MOONx02/wearable-mic-array/esp32s3/docs/flow_captions.png

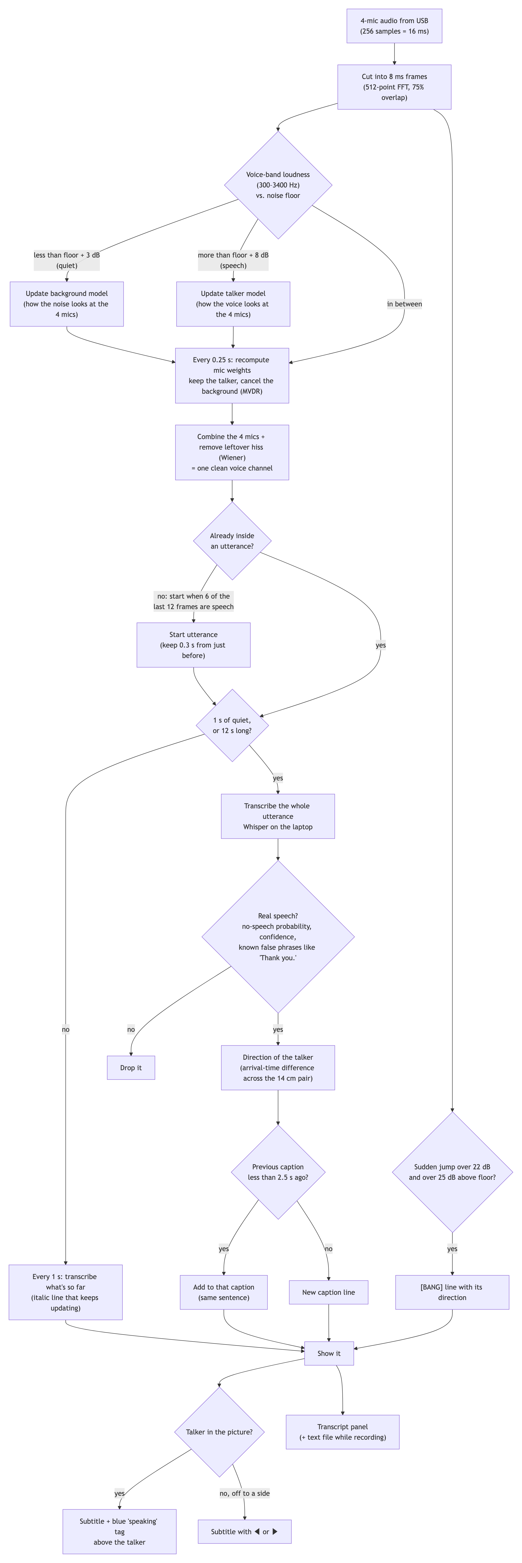
esp32s3/docs/flow_captions.png
