MOONx02/wearable-mic-array/esp32s3/docs/flow_firmware.png

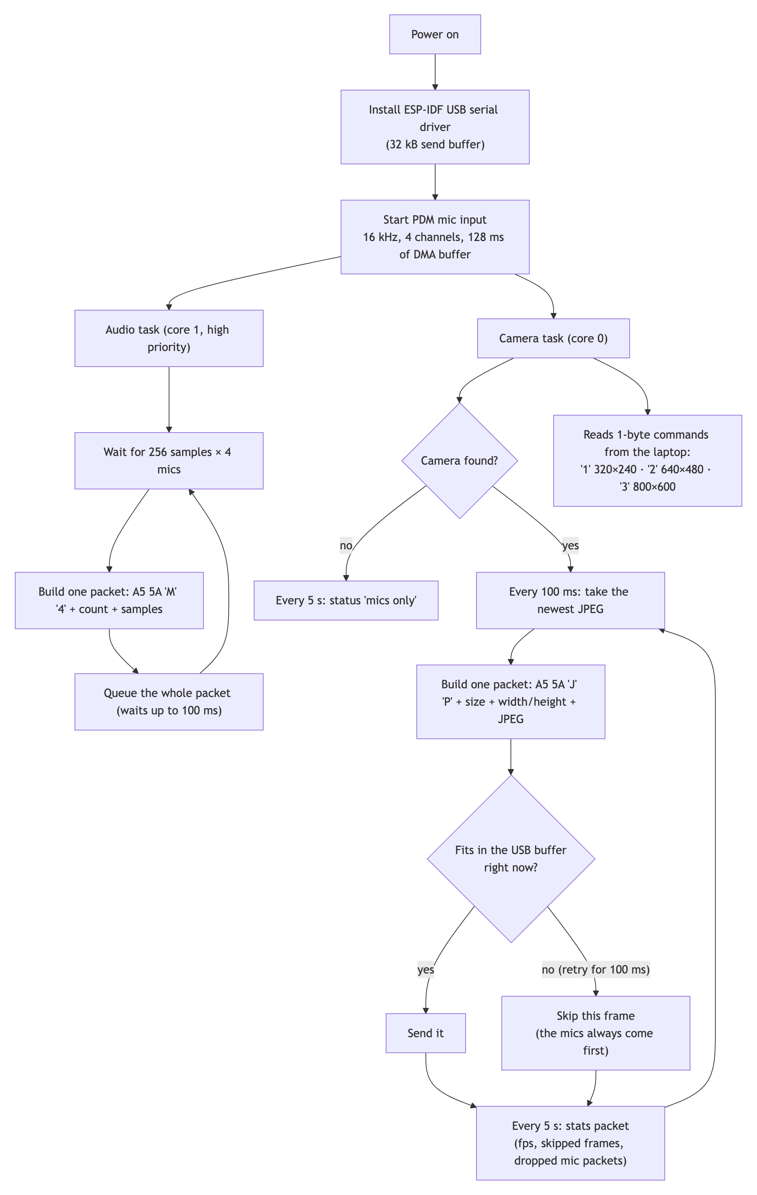
esp32s3/docs/flow_firmware.png
