MOONx02/wearable-mic-array/esp32s3/docs/flow_system.png

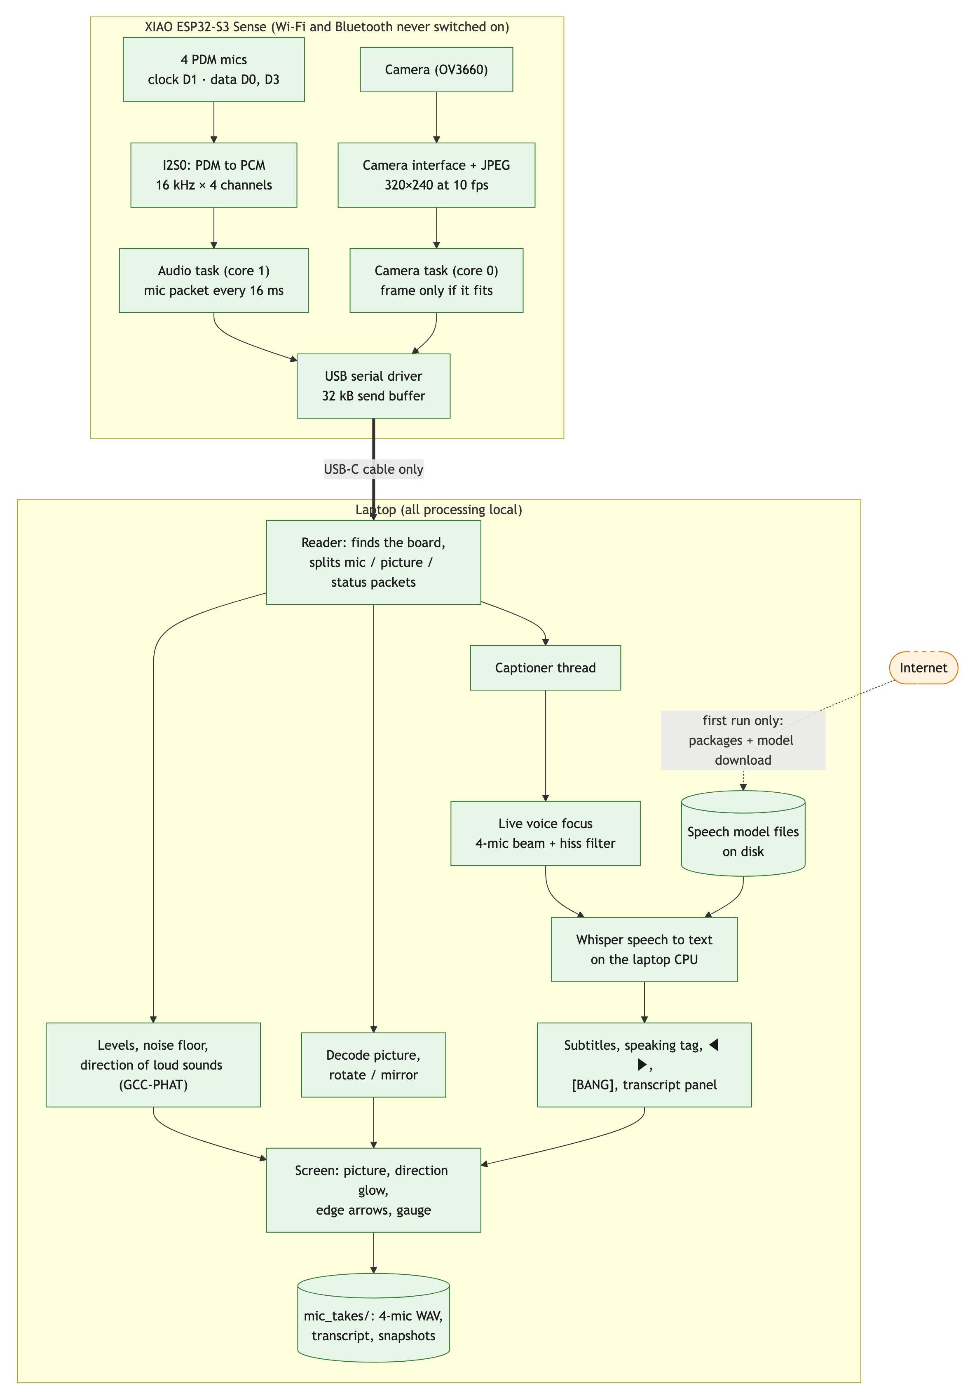
esp32s3/docs/flow_system.png
