MOONx02/wearable-mic-array/esp32s3/docs/readme_flow_locate_overlay.png

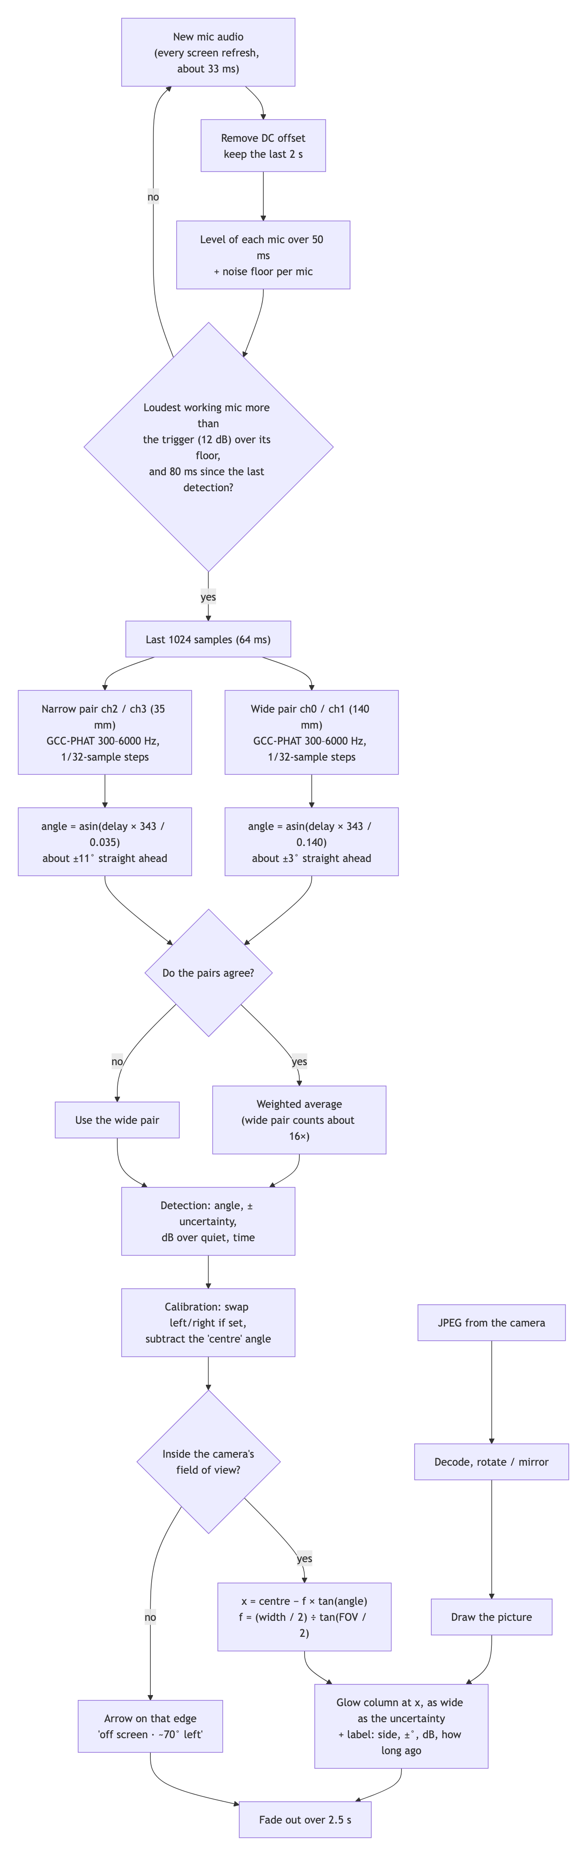
esp32s3/docs/readme_flow_locate_overlay.png
