MOONx02/wearable-mic-array/esp32s3/docs/readme_flow_overview.png

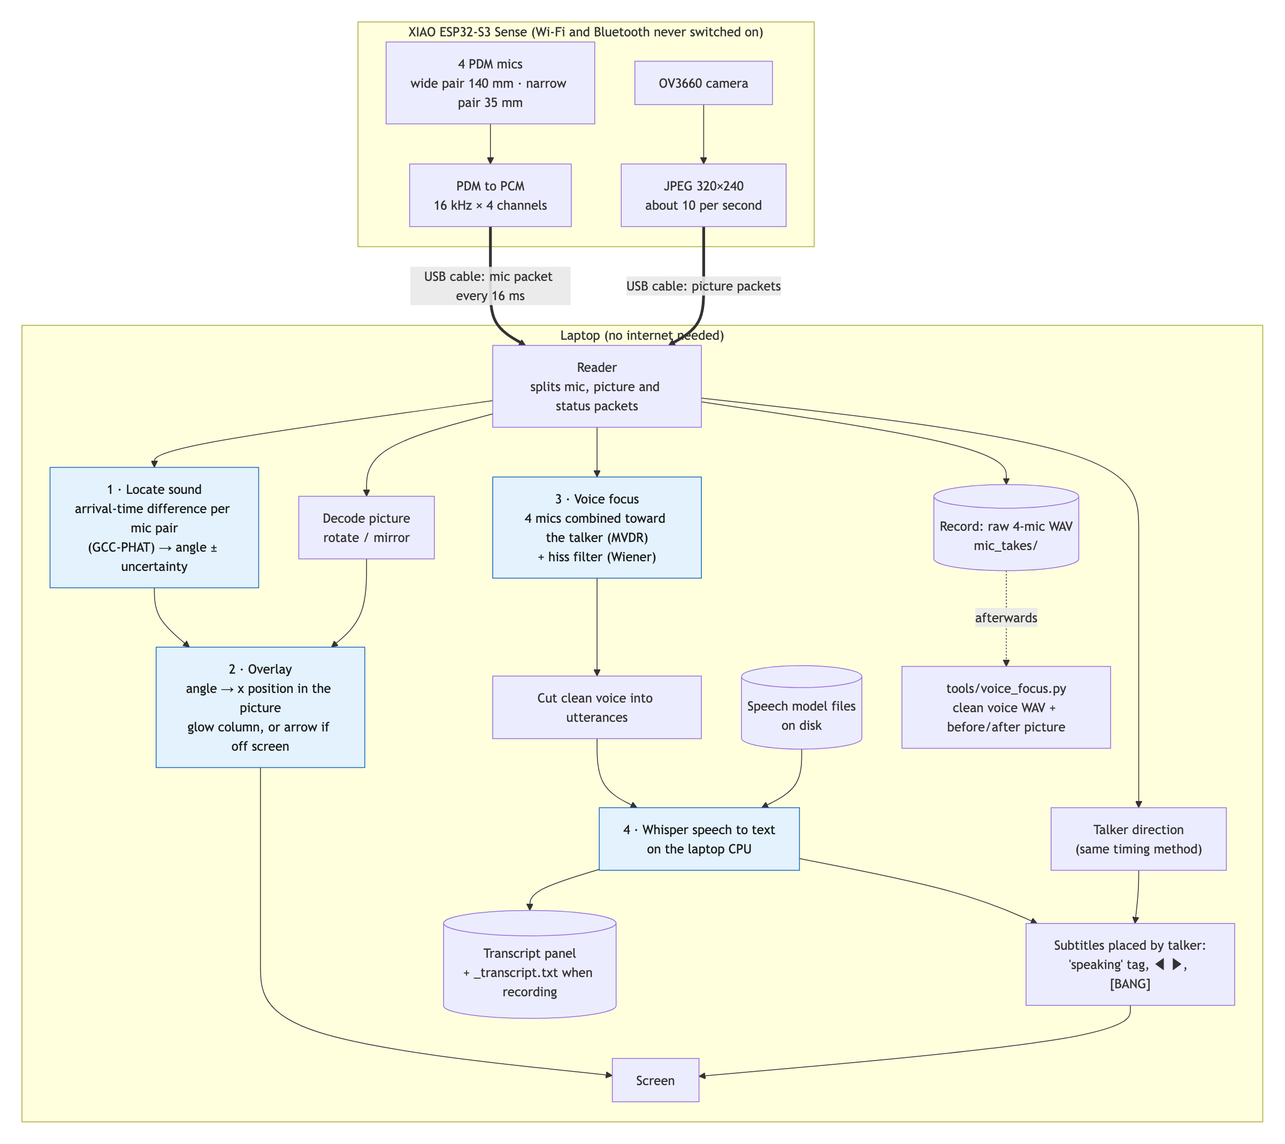
esp32s3/docs/readme_flow_overview.png
