MOONx02/wearable-mic-array/hud/out/hud_auto_t09.0.png

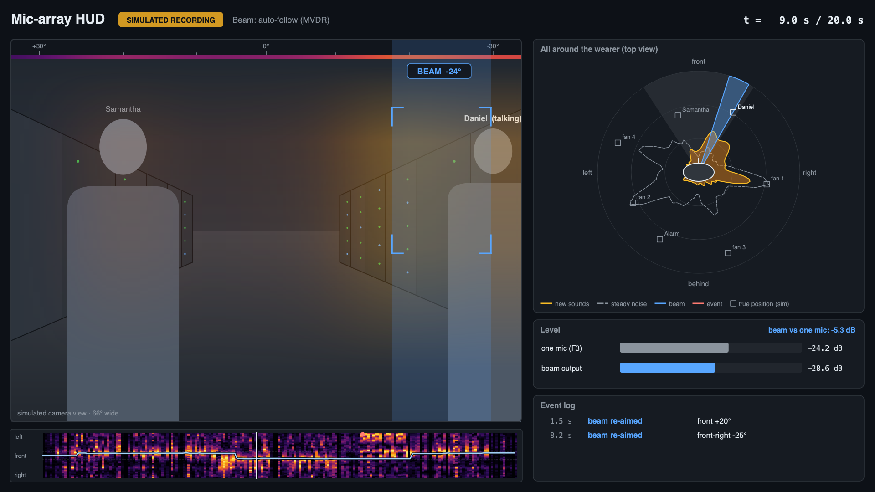
hud/out/hud_auto_t09.0.png
