MOONx02/wearable-mic-array/esp32s3/two_mic_bench_wiring.png

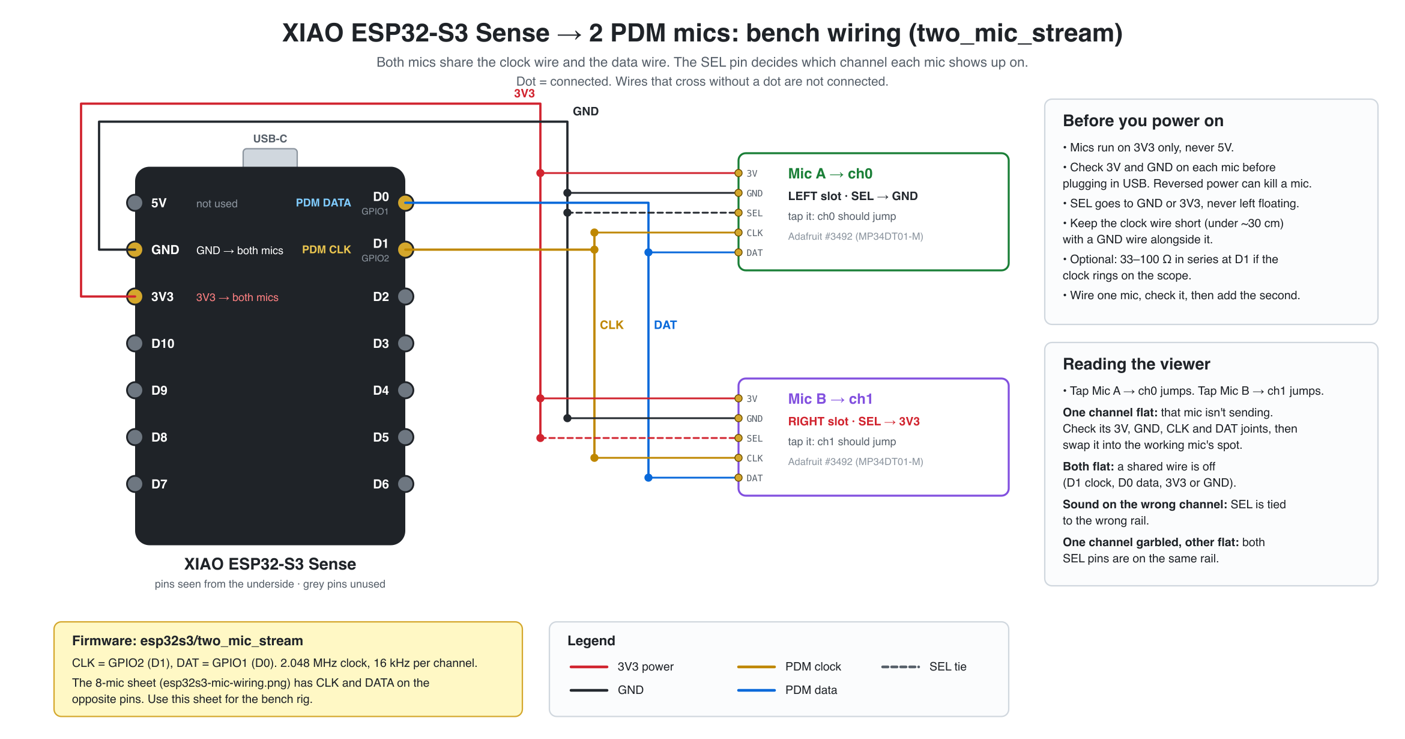
esp32s3/two_mic_bench_wiring.png
