MOONx02/wearable-mic-array/(commit log)

2026-10-30 Wearable mic array: ESP32-S3 firmware, laptop apps, tools and 8-mic roadmap
2026-10-30 Tablet app: faster subtitles (instant restart, on-device recognition when available, live words in transcript)
2026-10-30 Tablet app: Moonshine base re-reads each caption sentence offline; lighter main thread for smoother camera
2026-10-30 Tablet app: camera diagnostics in the status line, unstick a hung JPEG decode
2026-10-30 Tablet app: keep 64 USB reads queued so Android polls the board as often as a kernel serial driver
2026-10-30 Tablet app: grow WebUSB read size while reads come back full; show the newest of a burst of frames
2026-10-30 Tablet app: Find mode (beacon chirp from another phone, matched filter + pulse SRP); beacon.html; version in status; always revalidate files
2026-11-02 Tablet app v18: Calibrate mode (phone chirp on spots in the picture, several distances; fits camera aim, roll, view, height scale and camera offset), byte-escape support for Chrome Web Serial on macOS
2026-11-02 Tablet app v19: Camera button; with the camera off the tablet skips decoding frames, asks the board to shut its camera down ('c', firmware v4), and shows a big radar with arrows, turn hints, recent s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
2026-11-06 Web app v23: 8-mic vest by default, front/back from the chest and back plates
    - vest8 layout (chest 6 + back pair, 150 mm chest to back) is the default; tablets that saved vest6 move to it once
    - direction: angle from same-plate mic pairs weighted toward the plate facing the sound; front/back from which plate hears first and which is louder above 1 kHz (body shadow)
    - Whisper speech options, calibration guide, SD record tooltip (v20-v22)
2026-11-06 Web app v25: Find mode hears beacons and alarms behind the wearer (per-plate beacon scoring, tone front/back from level)
